DeepSkyDad/AF3/README.md

# Deep Sky Dad AF3

[ASCOM supported budget autofocuser](https://deepskydad.com/autofocuser3)
