DeepSkyDad/AF3/DeepSkyDad.AF3.Indilib/README.md

Development fork:
https://github.com/DeepSkyDad/indi

Production (master):
https://github.com/indilib/indi

INDI documentation:
https://indilib.org/devices/focusers/deepskydad-af1.html
