DeepSkyDad/AF3/DeepSkyDad.AF3.ASCOM/readme.jpg

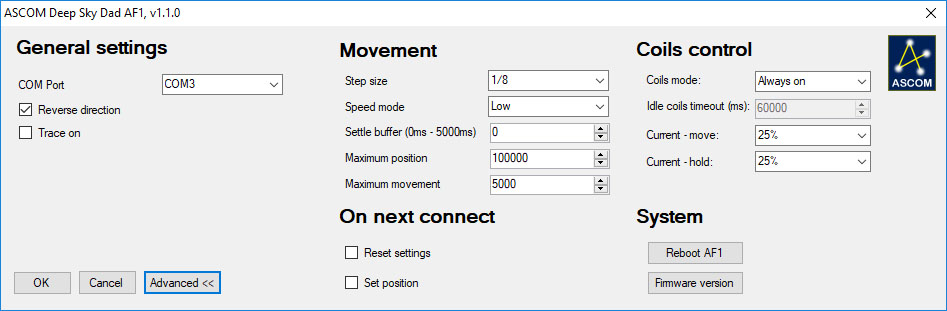
DeepSkyDad.AF3.ASCOM/readme.jpg
