DeepSkyDad/AF3/DeepSkyDad.AF3.Hardware/STL/AF3_motor_shell.stl

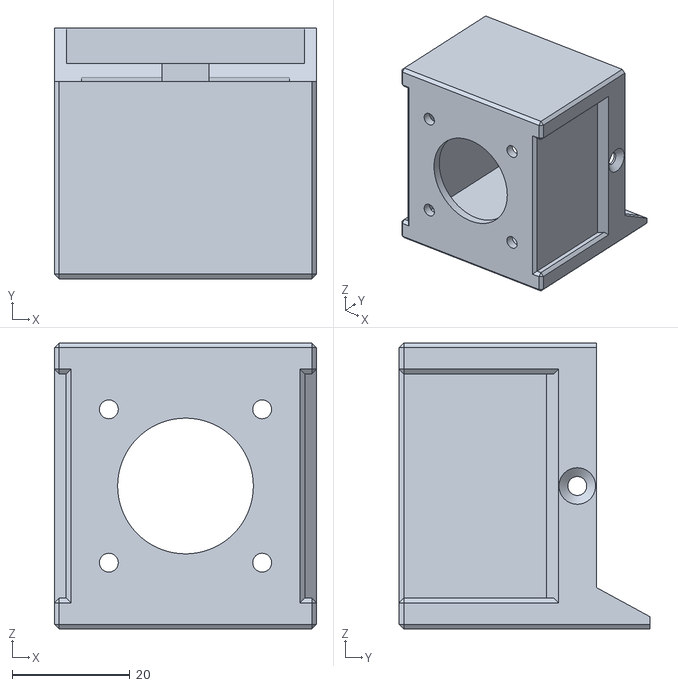
[picture p2: CAD file, 2019-12-02]
DeepSkyDad.AF3.Hardware/STL/AF3_motor_shell.stl
44.5 x 42.5 x 48.5
