DeepSkyDad/AF3/DeepSkyDad.AF3.Hardware/STL/AF3_motor_circuit.stl

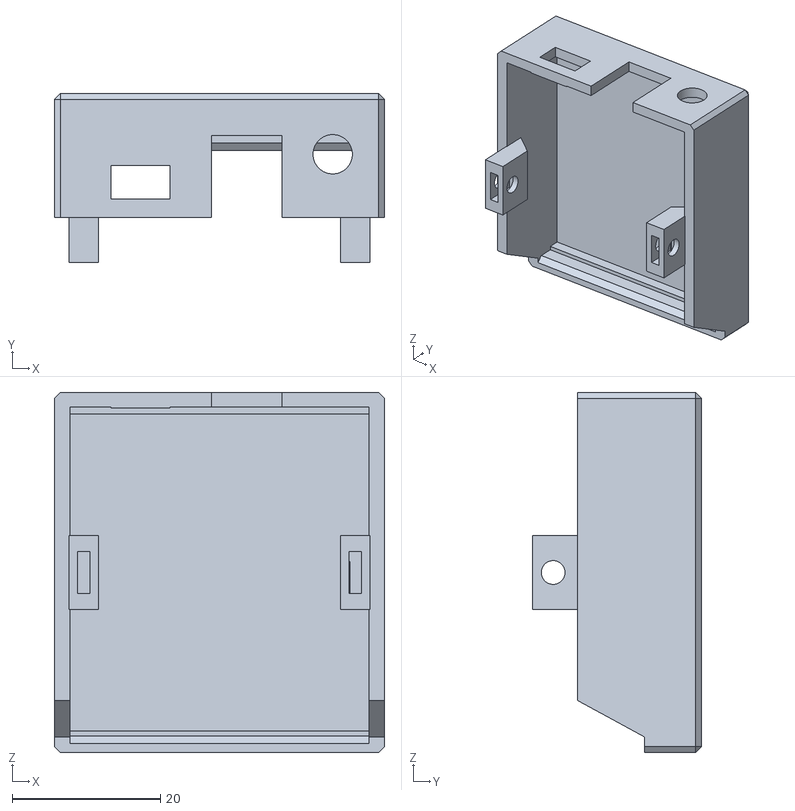
[picture p3: CAD file, 2019-12-02]
DeepSkyDad.AF3.Hardware/STL/AF3_motor_circuit.stl
44.5 x 22.8 x 48.5
