DeepSkyDad/AF3/DeepSkyDad.AF3.Hardware/STL/hc_bottom.stl

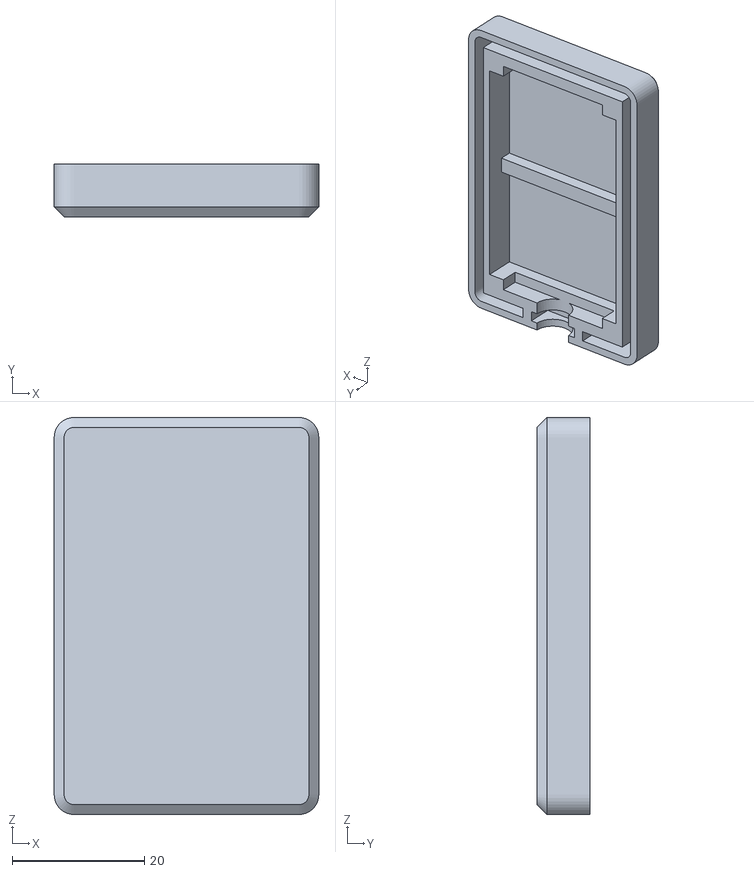
[picture p4: CAD file, 2019-12-02]
DeepSkyDad.AF3.Hardware/STL/hc_bottom.stl
40.0 x 8.00 x 60.0
