DeepSkyDad/AF3/DeepSkyDad.AF3.Hardware/STL/hc_cable_holder.stl

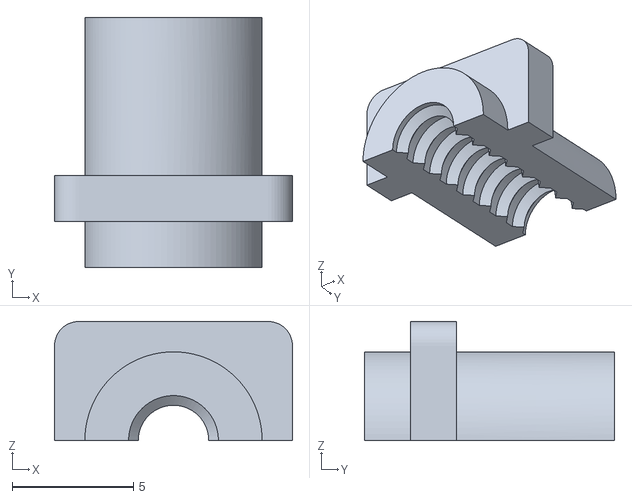
[picture p5: CAD file, 2019-12-02]
DeepSkyDad.AF3.Hardware/STL/hc_cable_holder.stl
9.80 x 10.3 x 4.90
