DeepSkyDad/AF3/DeepSkyDad.AF3.Hardware/STL/hc_top.stl

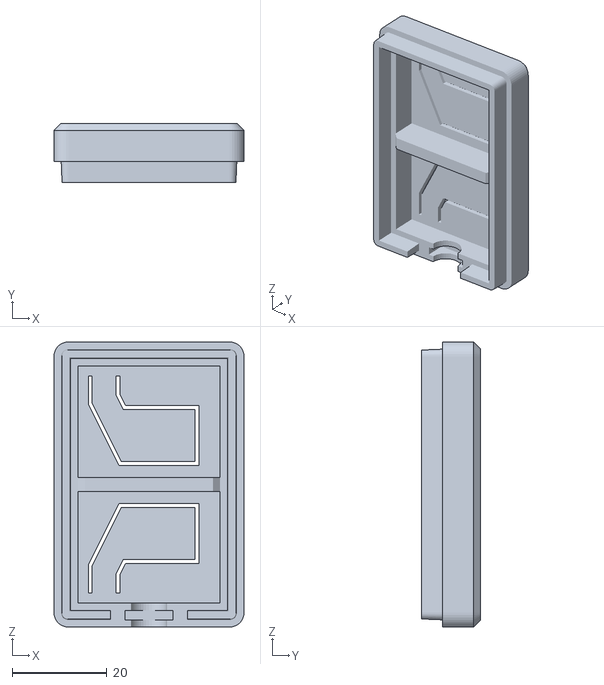
[picture p6: CAD file, 2019-12-02]
DeepSkyDad.AF3.Hardware/STL/hc_top.stl
40.0 x 12.5 x 60.0
