DeepSkyDad/AF3/DeepSkyDad.AF3.Hardware/schematic/DSD AF3.pdf

## MOTOR DRIVER

## NANO

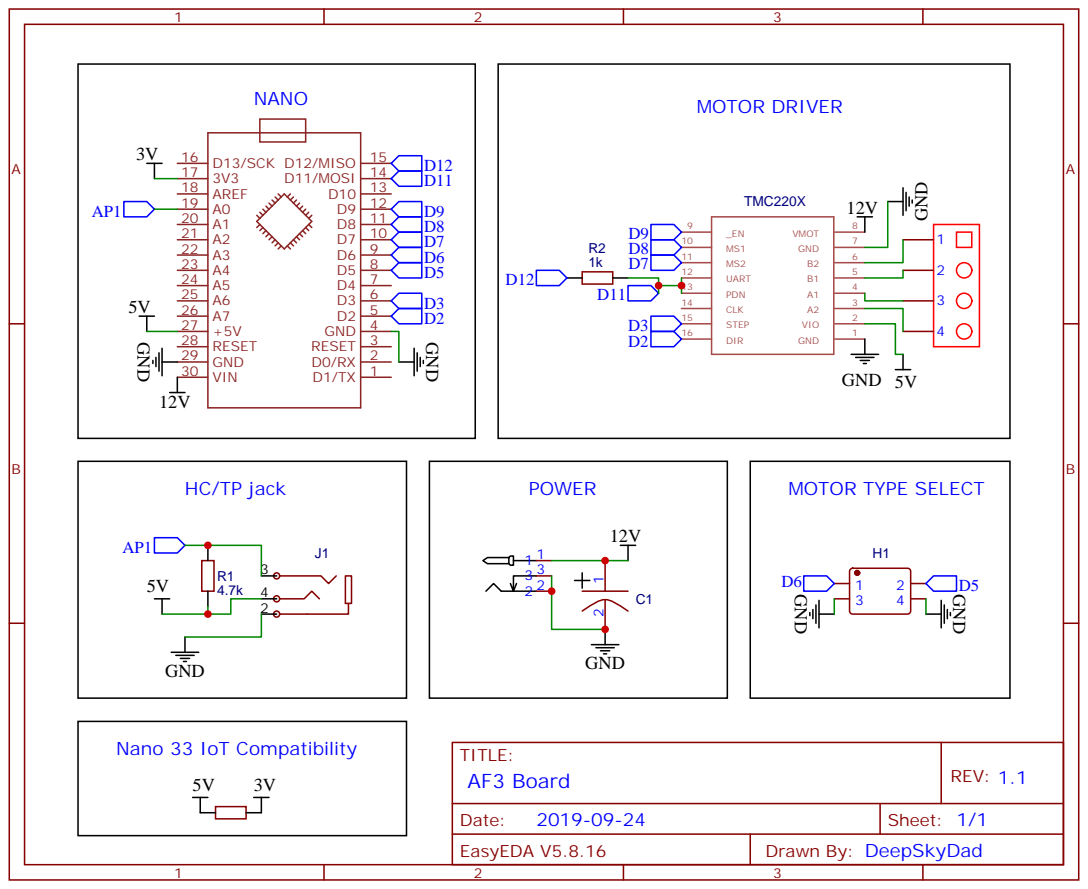
[picture p7: page 1]
