DeepSkyDad/AF3/DeepSkyDad.AF3.Hardware/schematic/DSD_HC_revA.pdf

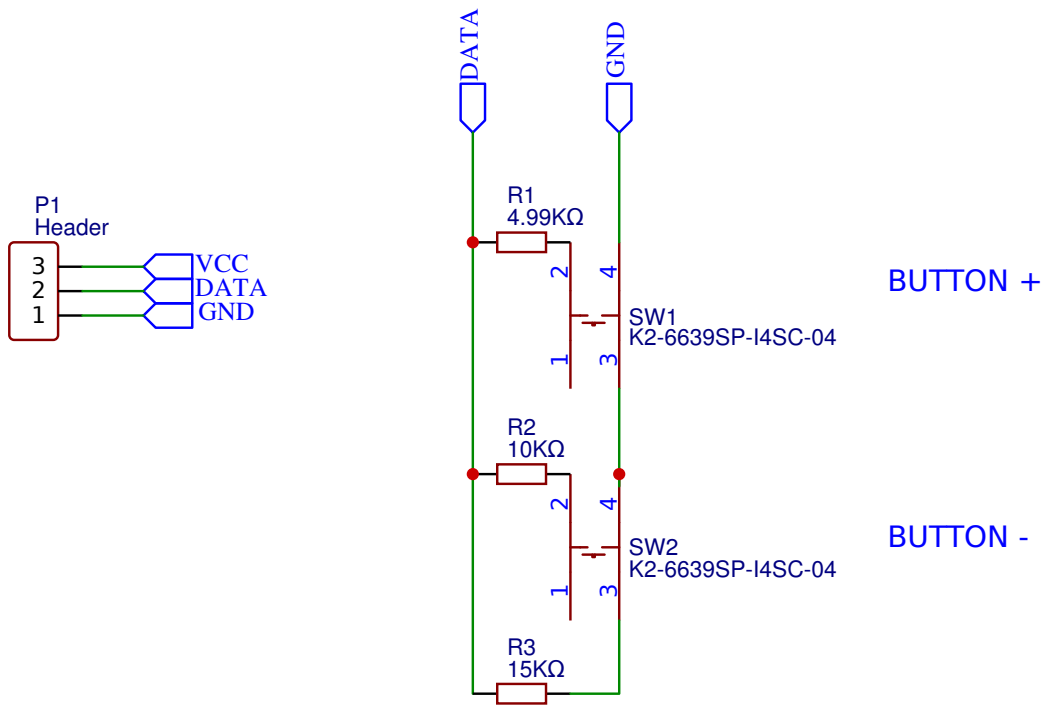
[picture p8: page 1]
TITLE:; DSD HC; REV: A; Date:; Sheet: 1/1; Header; GND; DATA; VCC; BUTTON +; BUTTON -

Company: Deep Sky Dad

Drawn By: Deep Sky Dad
