DeepSkyDad/AF3/DeepSkyDad.AF3.Arduino/src/Motor_AF3.cpp

#include <Arduino.h>
#include "Motor_AF3.h"
#include "Peripherals_AF3.h"

void Motor_AF3::_startMotor() {
    _motorIsMoving = true;
    _debouncingLastRunMs = millis();

    switch (_eeprom->getSpeedMode())
    {
        case 1:
            _motorMoveDelay = 96000;
            break;
        case 2:
            _motorMoveDelay = 48000;
            break;
        case 3:
            _motorMoveDelay = 24000;
            break;
        case 4:
            _motorMoveDelay = 8000;
            break;
        case 5:
            _motorMoveDelay = 4000;
            break;
    }

    _motorMoveDelay /= _eeprom->getStepMode();
}

void Motor_AF3::_stopMotor()
{
    if (_motorIsMoving && _eeprom->getSettleBufferMs() > 0)
        _settleBufferPrevMs = millis();
    _lastMoveFinishedMs = millis();

    _motorManualIsMoving = false;
    _motorManualIsMovingContinuous = false;
    _motorIsMoving = false;
    _eeprom->setTargetPosition(_eeprom->getPosition());
}

void Motor_AF3::_applyStepMode()
{
    unsigned short sm = _eeprom->getStepMode();
    //select microsteps (0,2,4,8,16,32,64,128,256)
    _driver.microsteps(sm == 1 ? 0 : sm); 
}

void Motor_AF3::_applyStepModeManual()
{
    unsigned short sm = _eeprom->getStepModeManual();
    //select microsteps (0,2,4,8,16,32,64,128,256)
    _driver.microsteps(sm == 1 ? 0 : sm); 
}

void Motor_AF3::_applyMotorCurrent() {
    _motorI = MOTOR_I_14HS10_0404S_04A;
    int d5 = digitalRead(MOTOR_SELECT_PIN_D5);
    int d6 = digitalRead(MOTOR_SELECT_PIN_D6);
    
    if(d5 == HIGH && d6 == HIGH) {
        _motorI = MOTOR_I_14HS10_0404S_04A;
    } else if(d5 == LOW && d6 == HIGH) {
        _motorI = MOTOR_I_14HS17_0504S_05A;
    } else if(d5 == HIGH && d6 == LOW) {
        //TODO
    } else if(d5 == LOW && d6 == LOW) {
        //TODO
    }

    int mA = _motorI*(((float)_eeprom->getMotorIMoveMultiplier())/100.0);
    float multiplier = ((float)_eeprom->getMotorIHoldMultiplier())/100.0;

    _driver.rms_current(mA, multiplier*0.8); // set hold multiplier to maximum of 80% of motor move current
}

bool Motor_AF3::init(EEPROM_AF3 &eeprom, Peripherals_AF3 &peri)
{
    _eeprom = &eeprom;
    _peri = &peri;
    
    if(!_pinsInitialized) {
        pinMode(TMC220X_PIN_DIR, OUTPUT);
        pinMode(TMC220X_PIN_STEP, OUTPUT);
        pinMode(TMC220X_PIN_MS1, OUTPUT);
        pinMode(TMC220X_PIN_MS2, OUTPUT);
        pinMode(TMC220X_PIN_ENABLE, OUTPUT);
        pinMode(MOTOR_SELECT_PIN_D5, INPUT_PULLUP);
        pinMode(MOTOR_SELECT_PIN_D6, INPUT_PULLUP);
        pinMode(A0, INPUT);

        digitalWrite(TMC220X_PIN_DIR, LOW);
        digitalWrite(TMC220X_PIN_STEP, LOW);
        digitalWrite(TMC220X_PIN_ENABLE, HIGH);
        _pinsInitialized = true;
    }

    _driver.begin();

    const uint32_t driverInputs = _driver.IOIN();
    if(_driver.CRCerror || driverInputs == 0)
        return false;

    if((driverInputs >> 24) == 0x21) { //TMC2209 (TMC2208 version is 0x20)
        //SPREAD pin (IOIN bit 8) inverts en_spreadCycle on TMC2209.
        _driver.en_spreadCycle((driverInputs & (1UL << 8)) != 0);
        _driver.TPWMTHRS(0); //keep stealthChop enabled at all speeds
    }

    /****** IMPORTANT - TMCStepper 0.6.2 lib overrides ********

    1. baudRate of SoftwareSerial for TMC2208 was reduced to 57600 due to Nano Every CRC issues on test_connection (DRV_STATUS) call (TMCS2208Stepper.cpp, beginSerial(57200)) 
    2. TMC2130Stepper::switchCSpin and TMC2660Stepper::switchCSpin digital write changed from digitalWrite(_pinCS, !state); to digitalWrite(_pinCS, state ? HIGH : LOW); because of AVR specifics (cant use boolean)
    
    ****** IMPORTANT - TMCStepper 0.6.2 lib overrides ********/
    int testConnection;
    for(int i=0; i<5; i++) {
        testConnection = _driver.test_connection();
        if(testConnection == 0)
            break;
    }
    
    if(testConnection != 0)
        return false;

    _driver.pdn_disable(true); //enable UART
    _applyMotorCurrent();
    _driver.mstep_reg_select(true); //enable microstep selection over UART
    _driver.I_scale_analog(false); //disable Vref scaling
    _applyStepMode();
    _driver.blank_time(24); //Comparator blank time. This time needs to safely cover the switching event and the duration of the ringing on the sense resistor. Choose a setting of 24 or 32 for typical applications. For higher capacitive loads, 3 may be required. Lower settings allow stealthChop to regulate down to lower coil current values. 
    _driver.toff(5); //enable stepper driver (For operation with stealthChop, this parameter is not used, but >0 is required to enable the motor)
    _driver.intpol(true); //use interpolation
    _driver.TPOWERDOWN(255); //time until current reduction after the motor stops. Use maximum (5.6s)
    digitalWrite(TMC220X_PIN_ENABLE, LOW); //enable coils

    _uartInitialized = true;
    return true;
}

bool Motor_AF3::isUartInitialized() {
    return _uartInitialized;
}

bool Motor_AF3::handleMotor() {
    /*_driver.DRV_STATUS();
    if(_driver.CRCerror) {
         Serial.print(millis());
         Serial.println("ms: CRC ERROR");
    }
    delay(10);*/

    if (_motorIsMoving) {
        //give priority to motor with dedicated 50ms loops (effectivly pausing main loop, including serial event processing)
        while (millis() - _debouncingLastRunMs < 50)
        {
            if(_motorManualIsMovingContinuous) {
                if(_motorManualIsMovingContinuousDir) {
                    _eeprom->setTargetPosition(_eeprom->getPosition() + 1);
                } else {
                    _eeprom->setTargetPosition(_eeprom->getPosition() - 1);
                }
            }

            if (_eeprom->getTargetPosition() < _eeprom->getPosition())
            {
                digitalWrite(TMC220X_PIN_DIR, _eeprom->getReverseDirection() ? HIGH : LOW);
                digitalWrite(TMC220X_PIN_STEP, HIGH);
                delayMicroseconds(1);
                digitalWrite(TMC220X_PIN_STEP, LOW);
                _eeprom->setPosition(_eeprom->getPosition() - 1);
                delayMicroseconds(_motorMoveDelay);
            }
            else if (_eeprom->getTargetPosition() > _eeprom->getPosition())
            {
                digitalWrite(TMC220X_PIN_DIR, _eeprom->getReverseDirection() ? LOW : HIGH);
                digitalWrite(TMC220X_PIN_STEP, HIGH);
                delayMicroseconds(1);
                digitalWrite(TMC220X_PIN_STEP, LOW);
                _eeprom->setPosition(_eeprom->getPosition() + 1);
                delayMicroseconds(_motorMoveDelay);
            }
            else
            {
                _stopMotor();
            }
            if(getMotorManualIsMovingContinuous() && _peri->readHcButton() <= 0) {
                _peri->handleHC();
            }
        }

        _debouncingLastRunMs = millis();
    }

    return _motorIsMoving;
}

void Motor_AF3::setMoveManual(bool motorManualIsMoving, bool motorManualIsMovingContinuous, bool motorManualIsMovingContinuousDir) {
    _motorManualIsMoving = motorManualIsMoving;
    _motorManualIsMovingContinuous = motorManualIsMovingContinuous;
    _motorManualIsMovingContinuousDir = motorManualIsMovingContinuousDir;
}

bool Motor_AF3::getMotorManualIsMoving() {
    return _motorManualIsMoving;
}

bool Motor_AF3::getMotorManualIsMovingContinuous() {
    return _motorManualIsMovingContinuous;
}

bool Motor_AF3::getMotorManualIsMovingContinuousDir() {
    return _motorManualIsMovingContinuousDir;
}

void Motor_AF3::startMotor() {
    _startMotor();
}

void Motor_AF3::stopMotor() {
    _stopMotor();
}

void Motor_AF3::applyStepMode() {
    _applyStepMode();
}

void Motor_AF3::applyStepModeManual() {
    _applyStepModeManual();
}

void Motor_AF3::applyMotorCurrent() {
    _applyMotorCurrent();
}

long Motor_AF3::getLastMoveFinishedMs() {
    long ms = _lastMoveFinishedMs;
    _lastMoveFinishedMs = 0L;
    return ms;
}

bool Motor_AF3::isMoving() {
    return _motorIsMoving;
}

bool Motor_AF3::isMovingWithSettle() {
    if (_motorIsMoving)
    {
        return true;
    }
    else
    {
        /*
            if your focuser has any play, this can affect the autofocuser performance. SGP for example goes aways from motorDir position and
            than starts traversing back. When it changes focus direction (traverse back), focuser play can cause FOV to wiggle just a bit,
            which causes enlongated stars on the next exposure. Settle buffer option returns IsMoving as TRUE after focuser reaches target position,
            letting it to settle a bit. Advices by Jared Wellman of SGP.
        */
        if (_eeprom->getSettleBufferMs() > 0L && _settleBufferPrevMs != 0L)
        {
            long settleBufferCurrenMs = millis();
            if ((settleBufferCurrenMs - _settleBufferPrevMs) < (unsigned long)_eeprom->getSettleBufferMs())
            {
                return true;
            }
            else
            {
                _settleBufferPrevMs = 0L;
                return true;
            }
        }
        else
        {
            return false;
        }
    }
}

void Motor_AF3::debug() {
    Serial.print("Motor full current (mA): ");
    Serial.println(_motorI);
    Serial.print("TMC DRV_STATUS: ");
    Serial.println(_driver.DRV_STATUS());
    Serial.print("TMC CRC error: ");
    Serial.println(_driver.CRCerror);
}

void Motor_AF3::legacyTest() {
    Serial.println("LEGACY MODE - START");
    digitalWrite(TMC220X_PIN_ENABLE, LOW);
    Serial.println("ENABLE LOW");
    
    Serial.println("MOVING STARTED");
    for(int i=0;i<500;i++) {
        digitalWrite(TMC220X_PIN_DIR, LOW);
        digitalWrite(TMC220X_PIN_STEP, HIGH);
        delayMicroseconds(1);
        digitalWrite(TMC220X_PIN_STEP, LOW);
        delayMicroseconds(8000);
    }
        Serial.println("MOVING FINISHED");

    digitalWrite(TMC220X_PIN_ENABLE, HIGH);
    Serial.println("ENABLE HIGH");

    Serial.println("LEGACY MODE - END");
}
