DeepSkyDad/AF3/(commit log)

2019-09-24 UART, motor select
2019-09-25 UART init, refactoring
2019-09-25 ASCOM driver, HC ranges
2019-09-26 move current multiplier, installer
2019-09-27 motor currents, auto discovery timings
2019-09-27 current tweaking
2019-09-27 HC/TP pin info into debug
2019-09-30 manual movement changes, ASCOM fixes
    [main.cpp]
2019-10-02 replaced tabs with spaces
    [main.cpp]
2019-10-08 ASCOM: set position minimum value bugfix Firmware: LEGT command added for legacy mode test, should UART fail (just to check if driver is alive)
    [main.cpp]
2020-01-07 sliding slots count fix
    [EEPROM_AF3.h]
2020-02-08 Nano Every upgrades, AF3 control panel bugfixes
    [EEPROM_AF3.cpp, EEPROM_AF3.h, main.cpp]
2020-05-12 v1.0.3 - initialization stability fixes
    [Motor_AF3.cpp, Serial_AF3.cpp, main.cpp]
2020-06-01 v1.0.2 - support for 2 instances of focuser simultaneously (in case you need 2 sets of settings or have 2 AF3 units)
2021-01-05 ASCOM v1.0.3 (temperature sensor bugfix: removed NotConnectedException, instead focuser returns -127C)
    Firmware v1.0.4 (temperature read fix: when called during motion, it caused motor pause)
    [Peripherals_AF3.cpp, Peripherals_AF3.h, main.cpp]
